howerj/bit-serial/(commit log)

2019-04-13 Initial commit
    This project is for a bit-serial CPU, written in VHDL, with a simulator
    for the system written in C. It should eventually be targeted to run on
    an actual FPGA after the simulation and design has been done.
    This is the initial commit, it does not contain a working simulation (C
    or VHDL) and the design *will* change as the current design is
    inadequate. At the moment the repository is more a play ground for
    ideas.
2019-04-13 Added primitive assembler, program counter working
    VHDL:
    * The test bench is very minimal at the moment, but the framework is in
    place. The program memory will need to be loaded from disk into Block
    RAM and then squeezed out through a shift register soon, but that is a
    task for later.
    * The makefile has been improved, new targets and things.
    * The program counter seems to be working.
    * I wonder if this is the simplest way of designing this processor,
    there seems to be an awful lot of repetition, and complication. It may
    need a redesign once it hits the FPGA toolchain...
    C/Simulator:
    * A simple assembler has been added. It is lacking forward references
    and many other amenities at the moment.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
    [bit.c, bit.vhd, tb.vhd]
2019-04-13 Added forward references, improved CPU implementation
    The CPU implementation now runs a little quicker as the program counter
    has been made to be smaller. Some more states have been implement, like
    LOAD and STORE, although they have not been tested.
    Forward references have been added to the assembler. There are still
    some assembler directives that are needed in order to make the assembler
    useful, however this is a good start.
2019-04-13 Made each cycle fixed length
    Variable length cycles will make the external interface more difficult
    to implement, so everything has been made to be fixed length.
    As a note, perhaps functions should be used to implement the shifting so
    it is easier to keep track of whether we are shifting things in the same
    direction or not.
    [bit.vhd]
2019-04-15 Merged nop/halt, added left/right shift
    The instruction set has been redesigned a little; nop has been removed
    and been replaced by the halt instruction (which can not optionally halt
    depending on the operand given). Perhaps this halt instruction could be
    turned into a CPU state get/set instruction?
    A left shift and a right shift instruction has been added as well.
    [bit.c, bit.vhd]
2019-04-15 Mostly working VHDL simulation CPU
    The CPU mostly works now, not all of the instructions have been tested,
    and the 'less' instruction needs to be implemented.
    Other changes:
    * Added a memory module skeleton, this will eventually contain a Block
    RAM module and Input/Output decoder, at the moment it only contains the
    shift registers that interface between that module and the outside
    world.
    * A test plan has been added to the 'bit.asm' file.
    * Test bench now includes the memory module, as does the makefile.
    * The bit order that the CPU does operations in has now been fixed, it
    does all operations where possible with the Least Significant Bit first.
    [bit.vhd, tb.vhd]
2019-04-16 Rearranged instruction set (again)
    A top level VHDL file now contains the project, and a block RAM module,
    which has been implemented, even if it is not correct at the moment.
    The instruction set has been changed, yet again, it is a little more
    compact and useful now. A few bugs have been fixed, there is now an
    instruction for manipulating the CPU status flags (which can also be
    used to reset or halt the processor). The less than instruction has been
    replaced with a subtract instruction which effects the CPU status flags.
    The CPU simulation is *almost* working correctly. There is now going to
    be a lot of debugging work to do.
    Some more TODO comments have also been added.
    [bit.c, bit.vhd, tb.vhd, top.vhd]
2019-04-17 Added VHDL build system, CPU still not working
    The CPU design is still not working correctly, however there have been a
    number of improvements and it appears closer to working. There should
    not have to be any radical changes to get the system working.
    The design synthesises and is quite small, using about 1% of the Spartan
    6 FPGA on the Nexys-3 board that the build currently targets. It of
    course uses a block RAM as well, but the CPU itself is tiny. The first
    task it to get it working, I will try to make it even smaller after.
    There will no doubt be problems in synthesis after the simulation is
    working as well.
    [bit.vhd, tb.vhd, top.vhd]
2019-04-17 Fixed flow control, stopped repeated instructions
    Flow control has been fixed so that the correct value is fetched
    from memory, however the CPU is still not running the example program
    correctly. It is just slightly closer to doing so.
    [bit.vhd]
2019-04-17 Corrected load/store
    load/store were using the accumulator for the address of where to
    load/store instead of the operand field. That has been correct.
    [bit.vhd]
2019-04-21 Simulated CPU working!
    The simulated version of the CPU is working, however this will not
    synthesize into anything sensible. That will have to be fixed. The test
    program does not exercise all instructions either, so there is still a
    few things to test before it can be declared correct. However, this is a
    good start.
    The test program adds a 1 to a memory location (which starts as 3)
    until it exceeds 15, then halts; it exercises addition, and, jumping,
    loading, storing and (some) flag setting.
    A few new directives and pseudo instructions have been added to the
    assembler as well, including; 'nop', 'clr', a single argument 'invert',
    allowing numbers to be directly embedded into the code, and '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
    [bit.c, bit.vhd]
2019-04-23 UART code, made cpu smaller, delay, and more
    The UART code has been added to the project, and LED output pins added
    to the top level module (which may be removed...). The UART code has not
    be integrated yet, but it would be a nice small test that the CPU is
    working and a step closer to implementing a more useful system on top of
    this CPU.
    'after delay' has been added to the BCPU module, but not elsewhere in
    the project.
    The processor has been simplified a little, code moved around, but it is
    functionally equivalent.
    The processor has also been made to be smaller. The current utilization
    hierarchy is:
    +---------------------------------------------------------------------------------------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
2019-04-24 Removed UART code, added LED driver
    The UART code has been removed, it might be added back in at a later
    date, I might also make a software only version of the UART driver.
    A driver for the LED has been added.
2019-04-25 Changed sub flags, moved done flag, shared adder
    Some of the VHDL changes include:
    * Sharing the adder logic between the add/subtract instruction, and the
    program counter increment.
    * Moved the done flag to the 'flag' register so there is one fewer
    register in the CPU, even if it is a one bit one. This actually seems to
    take up more resources so it might be removed.
    * The logic of the 'subtract' instruction has been changed, it is less
    flexible but it is easier to use and more practical. The initial
    underflow flag is forced to zero, and the final underflow result is
    stored in a different register, which is accessible by the user.
    The changes to the C simulator/assembler:
    * I/O functions h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
2019-04-27 Tested in hardware
    A short test program which worked in hardware was created that simply
    wrote to an I/O register was created. It worked on the Nexys-3 board.
    This is not a test of all of the CPUs functionality, but it is a start.
    Other improvements/changes:
    * The PNG file of the state-machine diagram for the CPU has been
    replaced with an SVG file, which is smaller and scalable.
    * Unfortunately the CPU is a little larger than it was before, but it is
    still tiny.
    * The documentation has been updated. As have some comments.
    - The tool-chain now has instructions
    - The CSS for the web-page which can be generated from the 'readme.md'
    file has been improved and reformatted. The larger imag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
    [bit.c, bit.vhd, tb.vhd, top.vhd]
2019-04-28 Broken: working on a new BRAM interface
    * The UART code has been added back in
    * The Block RAM has been separated out into a new module, allowing the
    memory and I/O to be dealt with independently. This breaks things for
    now, and will need to be fixed before merged into the mainline.
    +---------------------------------------------------------------------------------------------------------------------------------------------------------------------------------------+
    | Module | Partition | Slices* | Slice Reg | LUTs | LUTRAM | BRAM/FIFO | DSP48A1 | BUFG | BUFIO | BUFR | DCM | PLL_ADV | Full Hierarchical |
    +------------------------------------------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
    [bit.vhd, tb.vhd, top.vhd, uart.vhd, util.vhd]
2019-04-29 Fixed: New Block RAM module works
    The new Block RAM module has been integrated into the project and works
    now. This should allow the system to be extended easier, and the
    previous memory module was getting too crowded.
    * More assertions in the CPU.
    * Added a debug mode, selectable by a generic, in the CPU. When debug
    mode is on, during simulation only (the code is removed during synthesis as it
    not synthesizable), much easier to read debug information is printed out to the
    console. It would be better if the numbers were in hexadecimal format.
    * Parity computation can be selected to be even or odd at BCPU module
    instantiation.
    * More comments about the direction of the projec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
    [bit.vhd, peripherals.vhd, tb.vhd, top.vhd, util.vhd]
2019-04-29 Changed I/O, added UART in
    A UART module has been integrated into the project, but it is completely
    untested. This drastically increases the size of the project, as shown
    by the synthesis reports.
    It will be useful for bringing up the board and making sure that the
    hardware is doing what it should be. It would be well worth replacing
    the UART with a bit-banged version to save on a massive amount of space.
    +-------------------------------------------------------------------------------------------------------------------------------------------------------------------------------------------------+
    | Module | Partition | Slices* | Slice Reg | LUTs | LUTRAM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
2019-04-29 Changed I/O, added UART in
    The simulator needs this new peripheral adding in as well. This will
    allow me to write much more complex and meaningful programs, and have
    the ability to test them interactively.
    +------------------------------------------------------------------------------------------------------------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
2019-04-30 Added experimental code under 'experimental'.
    Code for a BCPU variant with an internal counter and interrupts has been
    added under an 'experimental' directory. However this nearly double the
    size of the core and the counter idea would not have worked that well.
    It should be possible to add interrupts with not that much size increase
    however.
    The code has been added so it is part of the repositories history, it
    will be removed in a later commit.
    * UART input/out has also been added to the simulator.
    * TODO comments have been moved around into the readme file
    * The makefile has an option in it to prevent 9KiB block RAMs from being
    used, because it causes problems according to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
    [bit.c, bit.vhd, peripherals.vhd, tb.vhd, top.vhd, uart.vhd, util.vhd]
2019-05-16 Added expression parser
    An expression parser has been added, which should be integrated into the
    assembler. The expression parser could be quite useful and integrated
    into other projects of mine as well, so it should be turned into a small
    library.
2019-06-23 Instruction set changes
    A few new instructions have been added and some removed.
    * 'sub' has been removed, along with the underflow flag.
    * 'invert' has been removed. 'xor' can be used instead, to make it more
    useful an indirection bit will need to be added to all arithmetic
    instructions.
    * 'in' and 'out' replace using 'load' and 'store' with a flag. Instead
    writing to I/O is done with these instructions. The flag for that has
    been removed as well.
    * The program counter can now be set and retrieved with two new
    instructions 'iJUMPI' and 'iPC'.
    * The CPU is slightly smaller (rearranging the flag bits so HLT is in
    position '6' would also make the CPU smaller still, but this has not
    been done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
    [bit.c, bit.vhd]
2019-06-23 Minor changes in the assembler
    This is all.
2019-06-23 Macros, indirection, documentation, ...
    * Indirection has been added, the operand is loaded from memory instead
    of being a literal value for the first eight instructions if the
    indirection bit is set.
    * A primitive macro system has been added to the project.
    * Documentation has been updated to reflect some, but not all, changes.
    * Some things in 'peripheral.vhd' have been renamed to stop some
    warnings GHDL was emitting.
    * The assembly program has been updated with some new macros, and some
    directives have been removed from the C file as they can be turned into
    macros.
    * Some instructions have been renamed and moved around in the C and the
    VHDL file.
    * The rotate function can be selected for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
2019-06-23 Minor updates to the assembler
    * Removed 'expr.c'
    * Cleaned up assembler a little.
    Speed: 105.660MHz
    | Module | Partition | Slices* | Slice Reg | LUTs | LUTRAM | BRAM/FIFO | DSP48A1 | BUFG | BUFIO | BUFR | DCM | PLL_ADV | Full Hierarchical Name |
    | top/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
2019-06-25 Removed diagrams, replaced jumpi, flags & pc
    The 'jumpi', 'flags' and 'pc' instructions have been removed in favor of
    two instructions that can set and get the values of certain registers
    based on their operand, via the accumulator. These are called 'set' and
    'get', unsurprising.
    Some more macros have been made, and an deficiency in the 'AND'
    instruction identified. This will need to be fixed.
    The out-of-date diagrams have also been removed.
    Speed: 105.502MHz
    | Module | Partition | S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
    [bit.c, bit.vhd]
2019-06-29 Include directive, fixed 'and', images
    * Added an include directive.
    * Fixed 'and' instruction so it works when indirection is on.
    * Updated the images for the state-machine and signal timing diagrams.
    +--------------------------------------------------------------------------------------------------------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
    [bit.c, bit.vhd]
2019-10-05 104.931MHz: merged in/out with get/set, gforth
    The assembler has been removed from 'bit.c' and instead an assembler
    written in forth, compiled with gforth, is now used. It should be more
    extensible and is already much more structured than the ad-hoc
    assembler written in C, whilst also being smaller. 'bit.c' now only
    contains the C simulator.
    The 'in/out' instructions have been merged with the 'get/set'
    instructions. I feel like there is still work to do in the instruction
    set as the system is still too awkward to use. Having to set and clear
    flags to get instructions to do certain things is not the best, but may
    be required.
    Much of the documentation has been removed, the project is not st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
2019-10-06 104.931MHz Changes to assembled program (not working)
    The assembled program has changed so the instructions that can be
    indirected are, this has highlighted some programs with the bit-serial
    core (in that the indirection does not quite work, or the assembled
    program is correct). Either way, this commit is just here to stash
    everything away.
    | Module | Partition | Slices* | Slice Reg | LUTs | LUTRAM | BRAM/FIFO | DSP48A1 | BUFG | BUFIO | BUFR | DCM | PLL_ADV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
    [bit.c, bit.vhd]
2020-06-21 104.931MHz: Fixed CPU -> test program works
    There was a problem with how indirection worked within the simulated
    CPU, this has now been fixed, the test program now works as intended.
    The CPU seems quite difficult to use however still, and seeing as I have
    not committed to the project in a while it is difficult to tell what is
    up to date and what is a good idea. I may have to revisit this project
    to see about it. None of the other instructions are guaranteed to work
    and most likely are buggy, I recall a big rewrite in the last few
    commits and then giving up because it was not working (because of the
    indirection).
    +-----------------------------------------------------------------------------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
    [bit.c, bit.vhd]
2020-06-21 Improved documentation
    The documentation for the system has been improved, the registers have
    been listed, removed unneeded TODO comments, and a makefile target has
    been added to talk to the device.
2020-06-23 Added outline of virtual machine
    An outline of a virtual machine has been added to the Forth image, this
    byte code interpreter will allow much more dense code to be made, and
    will make the CPU easier to program, allowing a simple Forth interpreter
    to be made. None of the assembly that makes up the virtual machine has
    been tested, and it in fact is lacking a lot of machinery that would
    allow it to work.
    The idea is to create a byte code interpreter, each instruction being
    8-bits in size, with an optional 8 or 16 bit operand. This, along with
    the fact that the virtual machine is a dual stack based virtual machine
    instead of an accumulator machine will allow software to be more
    quickly develop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
2020-06-25 New command line options, changed vm plan
    * The C program 'bit.c' now has more command line options.
    - The number of cycles the simulator runs for can now be set from the
    command line.
    - A header can be printed out every 32 cycles if tracing is enabled,
    which helps to deter which column is which.
    * Tracing now prints out a header
    * The design for the virtual machine, which is non-working, has been
    changed to be a indirect threaded code interpreter. It will need
    debugging (a lot) and possibly reworking. I hope to build a Forth
    interpreter on top of this.
    [bit.c]
2020-06-28 104.619MHz: Fixed CPU bug, (mostly) working VM
    * Improved tracing and tracing options in 'bit.c' - output of numbers
    can be decimal like the VHDL test bench.
    * Improved VHDL debug information, it now has a debug level option that
    allows state-transitions to be printed out to stdout if required
    * A few bugs have been fixed in the simulator; the indirection happened
    on the wrong CPU instruction bit, and some of the flags were not set
    correctly (parity and the zero flag should have been set at the start).
    * A bug has been fixed in the CPU which caused setting the program
    counter via the accumulator to fail. This has been fixed now, allowing a
    basic test program in the DTC VM in 'bit.fth' to wor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
    [bit.c, bit.vhd, tb.vhd, top.vhd]
2020-06-28 Optional FIFO, working UART example code
    * The FIFO for the UART can be turned on or off depending on a generic,
    it does not increase the size of the project as much as I thought it
    would. The UART module itself is far too large however and should be
    replaced with something more svelte.
    * The example code for the UART works, values can be pushed and popped
    on the virtual machines stack which in turn feed into the UART, writing
    the character 'H', this works in both the 'bit.c' simulator and the VHDL
    simulator. It has not yet been tested in the hardware...
    * The 'bit.c' simulator has been cleaned up a little, with better error
    messages and the merging of two structures. Also, the load/store
    in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
    [bit.c, peripherals.vhd, tb.vhd, top.vhd]
2020-07-02 104.619MHz: Improved simulation output
    * A TCL script is used to initialize the GTKWave waveform viewer, which
    makes viewing traces easier.
    * The simulation output from the C Simulator and the VHDL Simulator now
    match exactly, in format and content, at least with the default program.
    When it comes to I/O things will start to differ (as the C simulator is
    not going to be cycle accurate when it comes to I/O, not will both
    simulators be fed the same input necessarily). This has been used to
    find a bug in the Negative flag computation.
    * More documentation, comments, have been added.
    * The command line interface to the C simulator has been simplified.
    * The C simulator can now use the same confi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
    [bit.c, bit.vhd, tb.vhd]
2020-07-12 104.619MHz: more work on the cross-compiler
    * Developed rx/tx! words, improved the cross-compiler, added more
    untested words. The test program now prints out 'HELLO<cr><nl>'. There
    also has been various renames of things.
    * Added more comments around the VHDL code, and to the 'readme.md' file.
    * One of the registers in the VHDL UART module was not initialized to a
    value, when it should have been, leaving it in an undefined state, this
    has been fixed.
    | Module | Partition | Slices*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
    [bit.vhd, tb.vhd, uart.vhd]
2020-07-13 104.619MHz: baud select, pc - 1, forth machinery
    * The default baud rate of the system can be selected with by a generic,
    this is useful for simulation as it allows a much higher baud rate to be
    selected which means the processor spends less time waiting on the UART
    to send characters. It also should be noted that because the system is
    doing I/O and the I/O behaves slightly differently between the C
    simulator and the VHDL that the output of the two systems has started to
    diverge (it would be possible to bring them back together a little
    more).
    * A bug in the simulator has been found, an advanced program counter
    value was retrieved by the C simulator iGET instruction.
    * More of the Forth mach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
    [bit.c, peripherals.vhd, tb.vhd, top.vhd, uart.vhd]
2020-07-20 104.619MHz: type working, fixed bugs in basic words
    * The C simulator now gets raw characters from the terminal allowing a
    more UART like device to be simulated, it is still blocking however.
    * Bugs in basic words like '!' and '@' have been fixed, amongst some
    others. More words have been implemented as well.
    * A nearly working implementation of 'accept' has been added, which is a
    vital part of the REPL (forming the READ part of it), there are still a
    few bugs however.
    [bit.c]
2020-07-21 104.619MHz: new words, bug in u< found
    | top/ | | 0/102 | 0/234 | 0/273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
    [bit.c]
2020-08-16 123.369MHz/1534: UART size reduction
    +-----------------------------------------------------------------------------------------------------------------------------------------------------------------------------------------------------------------+
    +-----------------------------------------------------------------------------------------------------------------------------------------------------------------------------------------------------------------+
    | top/ |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
2020-08-20 123.369MHz/146E: Fixed bug in numeric output
    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
    [bit.c]
2021-01-01 123.369MHz/12C2: Minor update to simulation
    Changed some Unix simulation code for I/O handling, it now
    uses the correct file descriptor.
    [bit.c]
2023-08-24 123.369MHz/12C2: Updating documentation, spelling
    * Fixed some mistakes in the comments/documentation.
    * Added more documentation.
    [bit.c, bit.vhd, peripherals.vhd, tb.vhd, top.vhd, uart.vhd, util.vhd]
2024-02-10 123.369MHz/1214: More eForth size optimizations
    More optimizations relating to the eForth image size have been done,
    rearranging assembly words to avoid branching and removing headers for
    non-standard words. There is also more comments.
    [bit.c, bit.vhd]
2024-02-12 123.369MHz/11F2: Smaller image, debug print
    The image continues to shrink! More Forth for less! The main changes are
    using meta-compiled variables and constants.
    There is now a debug option for the `bit.c` VM. Options should be added
    to the CLI though.
2024-02-14 123.369MHz/11F0: Better debugging, fixed bug
    * Fixed a minor code generation bug which led to iSET/iGET producing
    incorrect results.
    * The debugging facilities in `bit.c` have been improved from
    non-existent to existent.
    * The image is smaller, yet again, the code generation bug fix meant
    that some constants could be removed.
    [bit.c, bit.vhd]
2024-02-15 123.369MHz/11F2: debugging, literal unneeded
    * Debugging has been improved more
    * The instruction `literal` is no longer needed and could be removed
    [bit.c, bit.vhd]
2024-02-16 123.369MHz/F7E: new threading model, saved space
    Lots of space has been saved with a new threading model, over 500 bytes,
    putting the eForth system under the 4KiB boundary which is pretty neat.
    Indirect threading is now used, and the "execute" VM instruction has
    been removed. A few more comments have been made, and a few other minor
    changes, a minor bug in sleeping has been fixed in `bit.c`.
    [bit.c, tb.vhd]
2024-02-20 123.369MHz/F24: Improved test bench interactivity
    * The forth image is slightly smaller, this was achieved by using
    "compile," where it could be.
    * The test bench has been improved massively, it takes a while to run
    (minutes), but it is possible to interact with the Forth interpreter
    in the VHDL simulation.
    * A few more comments have been added.
    [tb.cfg]
2024-02-21 123.369MHz/F1E: Documentation, testbench, image
    * The image is slightly smaller.
    * The test bench interactivity has been improved, a CR then LF is sent
    instead of just a LF.
    * The documentation has been updated to reflect the removal of the
    indirect flag, and to include the synthesis results.
    [tb.cfg]
